maximerochat/GS_BEAMBREAKER/README.md

# GS_BEAMBREAKER
This project is a first iteration of 2.4GHz FSK signal beam steering

I'll try do document this project along it's advancement.

# Table of content
- [Basic ideas and calculation](docs/basic_calculations.md)
- [Hardware](docs/hardware.md)
- [Antenna Design](docs/antenna_design.md)
- ...

# Goal of this project 
I'm not a professional RF designer, just an enthusiastic Computer Science student trying to understand the complexity of beam forming. Since I had trouble finding guide about basic beam forming hardware and software, I'm trying to produce good material for future person like me. If you are interested in collaborating or want to correct me and point out mistakes I'm made, feel free to contact me or to raise issues.

# Notice
I am currently only working on the physics and thinking of the project, I'll try do documentate everything along my research. This means that the current hardware template is not accurate, it's juste a basic implementation of a SX1280 radio (I didn't tested it for the moment, I'm about to produce it in a few weeks). The hardware for this project I hope will be built during the next academic semester, I'll try to contact some labs in my university (EPFL) to see if they can help me in my jounrey

# Ressources
- bible of phased array : http://twanclik.free.fr/electricity/electronic/pdfdone11/Phased.Array.Antenna.Handbook.Artech.House.Publishers.Second.Edition.eBook-kB.pdf
- square patch antenna design : https://www.researchgate.net/publication/319176011_Design_Analysis_of_Square_Microstrip_Patch_Antenna
- basic interference pattern model : https://www.claytex.com/blog/modelling-of-phased-array-antenna/
- courses about phased array : https://zinka.wordpress.com/material/
- Antenna design :
  - https://www.researchgate.net/publication/292508017_Design_of_microstrip_antenna_for_wireless_communication_at_24_GHZ
  - calculator : https://resources.altium.com/fr/p/microstrip-patch-antenna-calculator-rf-designers
