maximerochat/GS_BEAMBREAKER/hardware/CAD/NX2016SA_52MHZ_EXS00A_CS07103/NX2016SA-52MHZ-EXS00A-CS07103.step

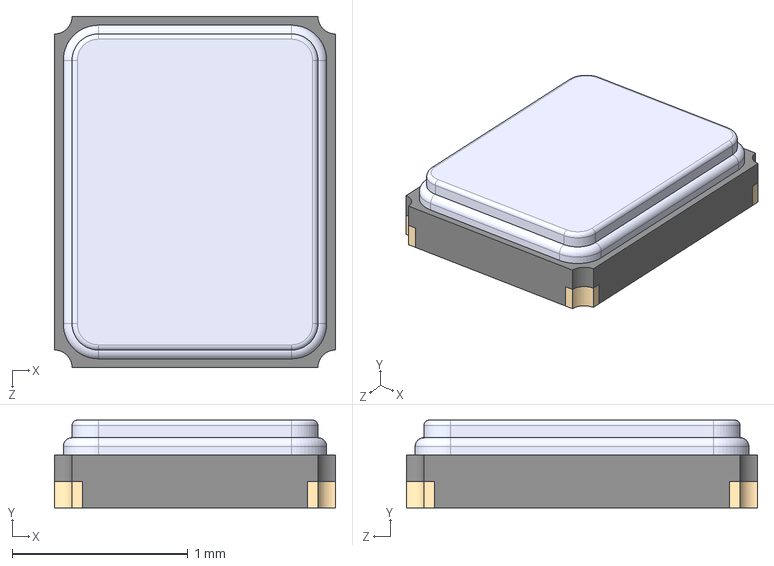
[picture p1: CAD file, 2024-01-11]
hardware/CAD/NX2016SA_52MHZ_EXS00A_CS07103/NX2016SA-52MHZ-EXS00A-CS07103.step
1.60 x 0.5 x 2.00 mm
