maximerochat/GS_BEAMBREAKER/hardware/CAD/SX1280IMLTRT--3DModel-STEP-56544.step

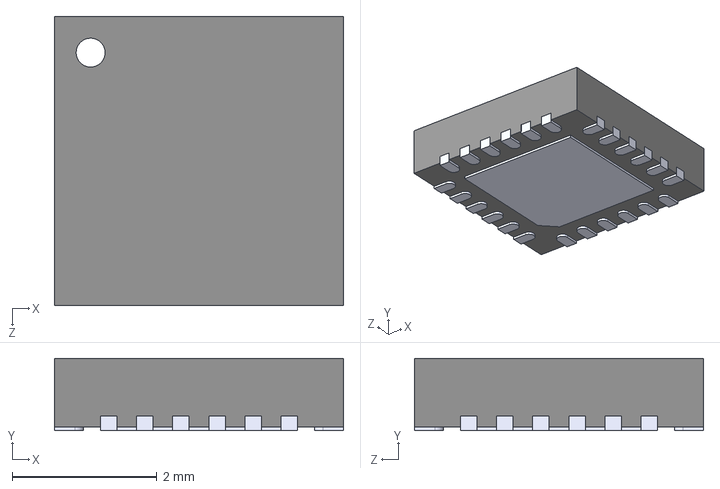
[picture p2: CAD file, 2024-01-11]
hardware/CAD/SX1280IMLTRT--3DModel-STEP-56544.step
4.00 x 1.00 x 4.00 mm
