maximerochat/GS_BEAMBREAKER/hardware/BeamFormer_FrontEnd.kicad_sch

## KiCad design hardware/BeamFormer_FrontEnd.kicad_sch (2024-01-15)

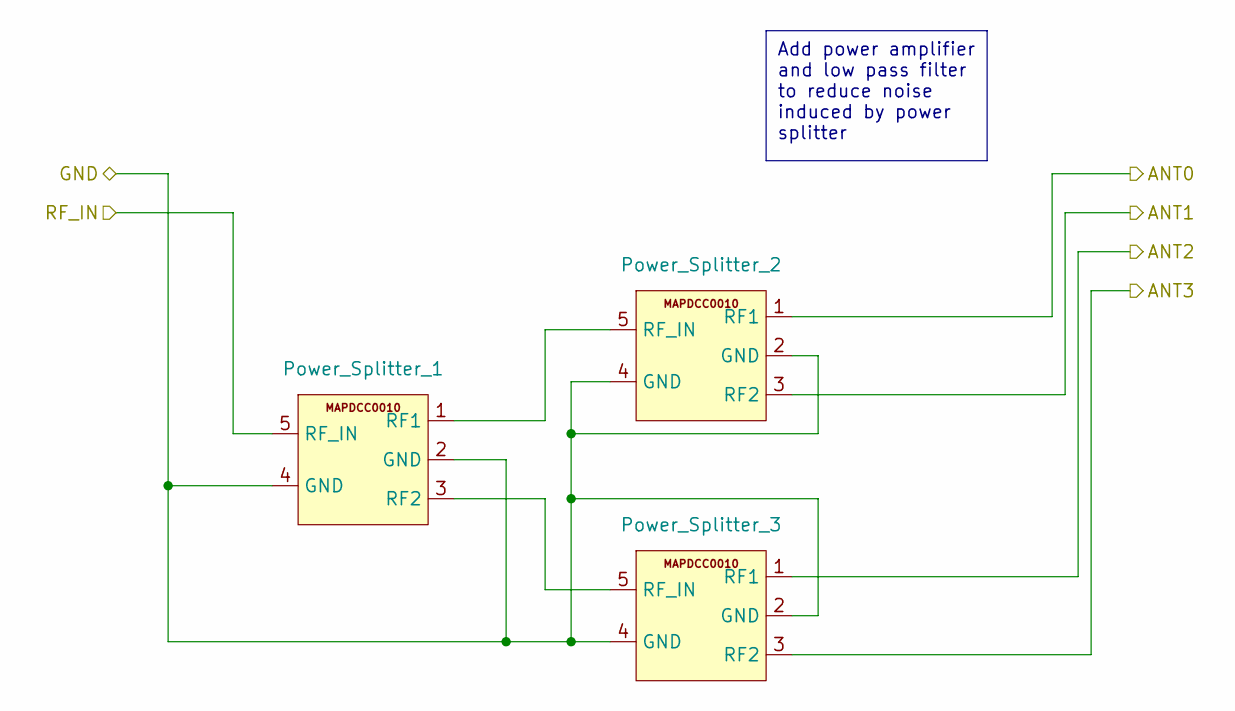
[picture p3: schematic BeamFormer_FrontEnd.kicad_sch]

Parts:
Power_Splitter_1, Power_Splitter_2, Power_Splitter_3: SOT95P285X145-5N

Connections:
ANT0: Power_Splitter_2.1 (RF1)
ANT1: Power_Splitter_2.3 (RF2)
ANT2: Power_Splitter_3.1 (RF1)
ANT3: Power_Splitter_3.3 (RF2)
GND: Power_Splitter_1.2 (GND), Power_Splitter_1.4 (GND), Power_Splitter_2.2 (GND), Power_Splitter_2.4 (GND), Power_Splitter_3.2 (GND), Power_Splitter_3.4 (GND)
unnamed: Power_Splitter_1.1 (RF1), Power_Splitter_2.5 (RF_IN)
unnamed: Power_Splitter_1.3 (RF2), Power_Splitter_3.5 (RF_IN)
RF_IN: Power_Splitter_1.5 (RF_IN)

Notes on the sheet:
Add power amplifier and low pass filter to reduce noise induced by power splitter
