maximerochat/GS_BEAMBREAKER/hardware/GS_BEAMBREAKER.kicad_sch

## KiCad design hardware/GS_BEAMBREAKER.kicad_sch (2024-01-16, an earlier design)

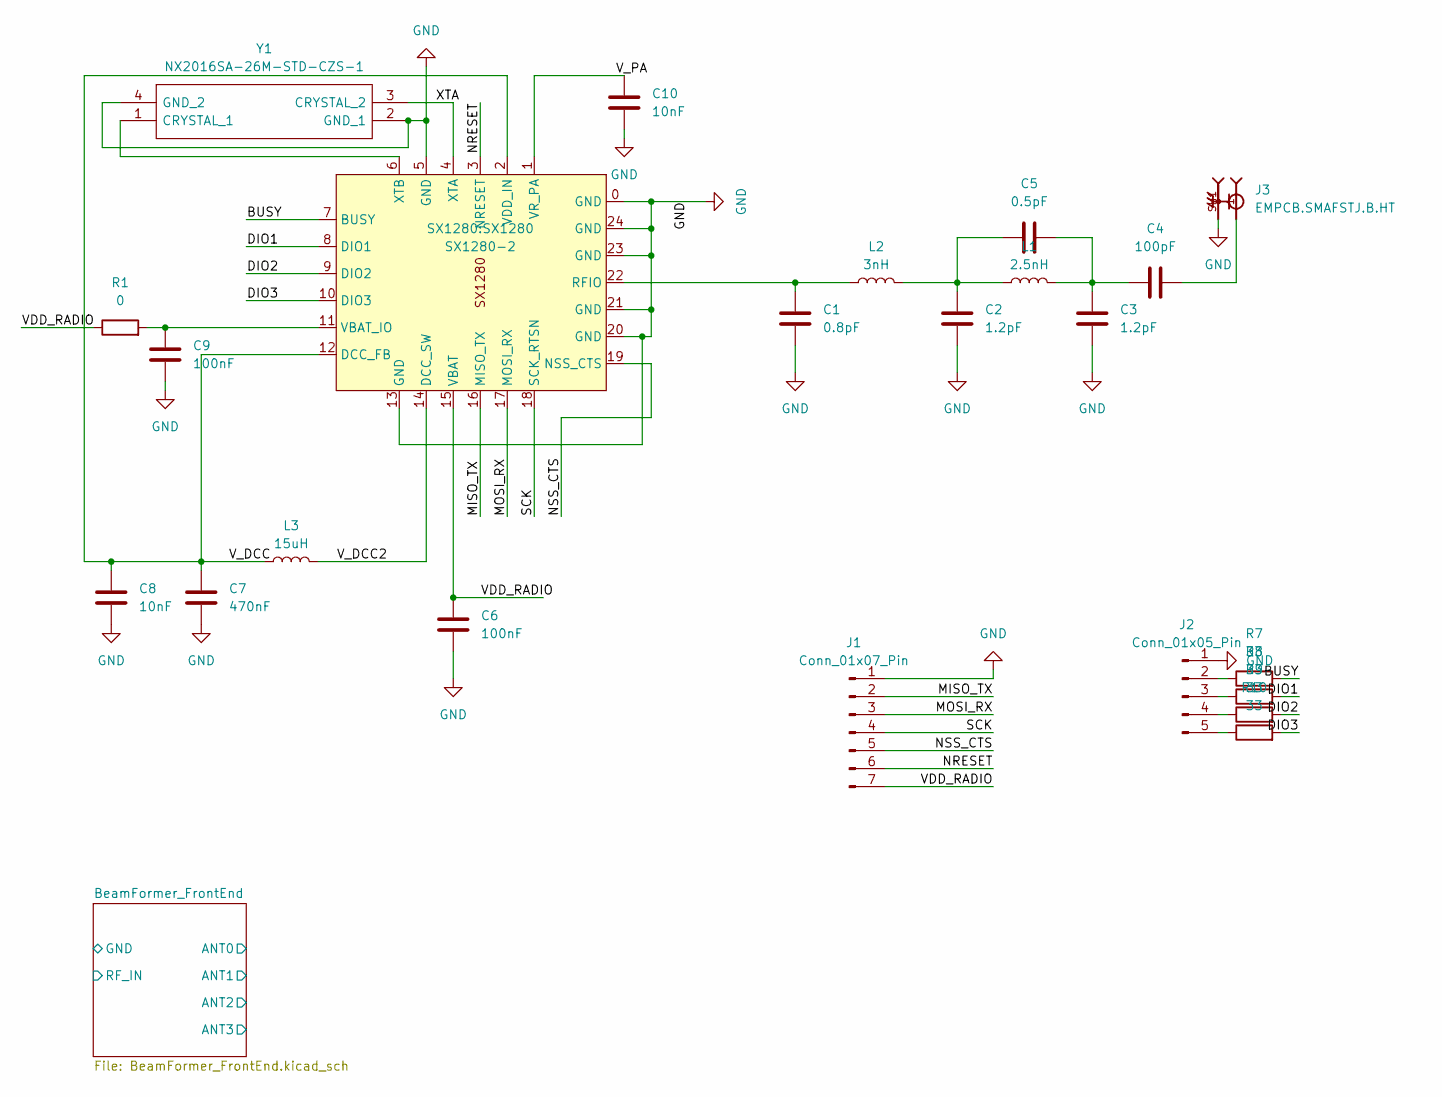
[picture p4: schematic GS_BEAMBREAKER.kicad_sch]

Parts:
C1: 0.8pF; C_0402_1005Metric
C2, C3: 1.2pF; C_0402_1005Metric
C4: 100pF; C_0402_1005Metric
C5: 0.5pF; C_0402_1005Metric
C6, C9: 100nF; C_0402_1005Metric
C7: 470nF; C_0402_1005Metric
C8, C10: 10nF; C_0402_1005Metric
J1: Conn_01x07_Pin; PinHeader_1x07_P2.00mm_Vertical
J2: Conn_01x05_Pin; PinHeader_1x05_P2.00mm_Vertical
J3: EMPCB.SMAFSTJ.B.HT; TAOGLAS_EMPCB.SMAFSTJ.B.HT
L1: 2.5nH; L_0402_1005Metric
L2: 3nH; L_0402_1005Metric
L3: 15uH; L_0805_2012Metric
R1: 0; R_0402_1005Metric
R7, R8, R9, R10: 33; R_0402_1005Metric
SX1280-2: SX1280
Y1: NX2016SA-26M-STD-CZS-1; NX2016SA26MSTDCZS1; Mouser Part Number 344-NX2016SA26MSTZS1

Connections:
BUSY: R7.2, SX1280-2.7 (BUSY)
DIO1: R8.2, SX1280-2.8 (DIO1)
DIO2: R9.2, SX1280-2.9 (DIO2)
DIO3: R10.2, SX1280-2.10 (DIO3)
GND: C1.2, C2.2, C3.2, C6.2, C7.2, C8.2, C9.2, C10.2, J1.1, J2.1, J3.SH1, SX1280-2.0 (GND), SX1280-2.5 (GND), SX1280-2.13 (GND), SX1280-2.20 (GND), SX1280-2.21 (GND), SX1280-2.23 (GND), SX1280-2.24 (GND), Y1.2 (GND_1), Y1.4 (GND_2)
MISO_TX: J1.2, SX1280-2.16 (MISO_TX)
MOSI_RX: J1.3, SX1280-2.17 (MOSI_RX)
NRESET: J1.6, SX1280-2.3 (NRESET)
NSS_CTS: J1.5, SX1280-2.19 (NSS_CTS)
unnamed: C1.1, L2.1, SX1280-2.22 (RFIO)
unnamed: C2.1, C5.1, L1.1, L2.2
unnamed: C3.1, C4.1, C5.2, L1.2
unnamed: C4.2, J3.1
unnamed: C9.1, R1.2, SX1280-2.11 (VBAT_IO)
unnamed: J2.2, R7.1
unnamed: J2.3, R8.1
unnamed: J2.4, R9.1
unnamed: J2.5, R10.1
unnamed: SX1280-2.6 (XTB), Y1.1 (CRYSTAL_1)
SCK: J1.4, SX1280-2.18 (SCK_RTSN)
VDD_RADIO: C6.1, J1.7, R1.1, SX1280-2.15 (VBAT)
V_DCC: C7.1, C8.1, L3.1, SX1280-2.2 (VDD_IN), SX1280-2.12 (DCC_FB)
V_DCC2: L3.2, SX1280-2.14 (DCC_SW)
V_PA: C10.1, SX1280-2.1 (VR_PA)
XTA: SX1280-2.4 (XTA), Y1.3 (CRYSTAL_2)
