maximerochat/GS_BEAMBREAKER/(commit log)

2024-01-15 modified project structure + added start of documentation structure
    [GS_BEAMBREAKER_V12PRO_MAX.kicad_pcb, GS_BEAMBREAKER_V12PRO_MAX.kicad_sch, NX2016SA-52MHZ-EXS00A-CS07103.step, SX1280IMLTRT--3DModel-STEP-56544.step]
2024-01-15 doc change + hardware project structure
    [BeamFormer_FrontEnd.kicad_sch, GS_BEAMBREAKER.kicad_pcb, GS_BEAMBREAKER.kicad_sch, NX2016SA-52MHZ-EXS00A-CS07103.step, SX1280IMLTRT--3DModel-STEP-56544.step]
2024-01-16 antenna doc start
2024-01-16 doc update
    [GS_BEAMBREAKER.kicad_sch]
2024-01-26 Update README.md with a short notice on the project current state
